dakesan/cat-robot-straight-learning/projects/cat-robot-learning/src/catrobot/assets/shapr3d-20261029/solid-01.obj

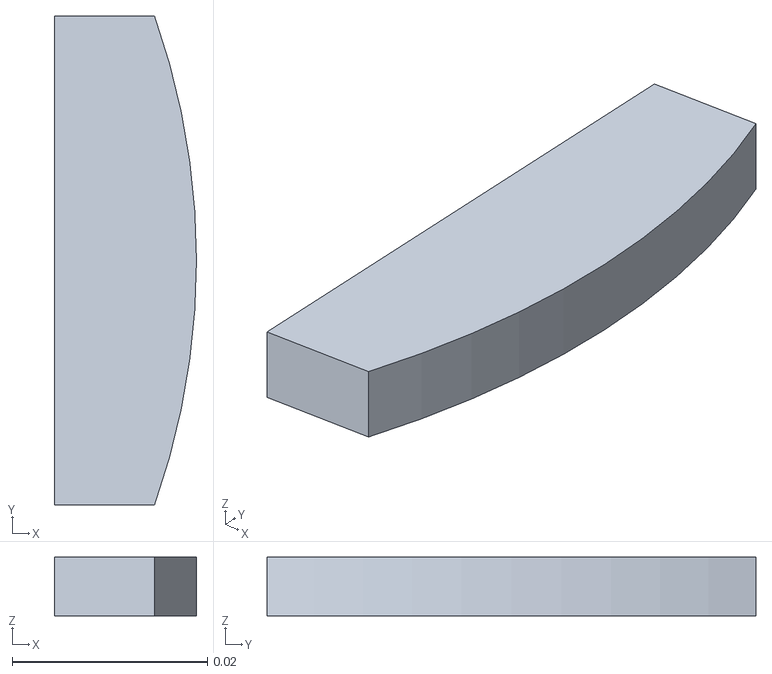
[picture p8: CAD file, 2026-11-01]
projects/cat-robot-learning/src/catrobot/assets/shapr3d-20261029/solid-01.obj
0.0145 x 0.05 x 0.006
