dakesan/cat-robot-straight-learning/projects/cat-robot-learning/src/catrobot/assets/shapr3d-20261029/solid-03.obj

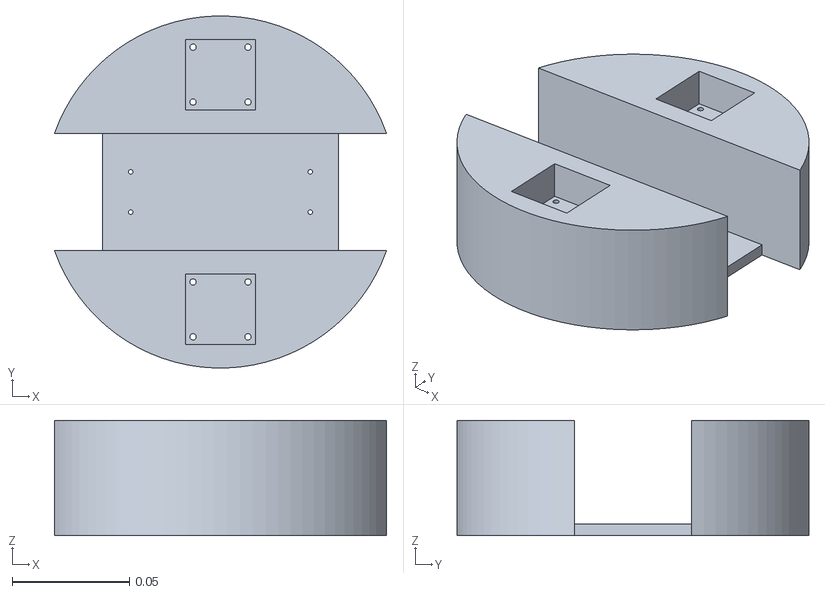
[picture p9: CAD file, 2026-11-01]
projects/cat-robot-learning/src/catrobot/assets/shapr3d-20261029/solid-03.obj
0.141 x 0.15 x 0.049
