dakesan/cat-robot-straight-learning/projects/cat-robot-learning/src/catrobot/assets/shapr3d-20261029/chassis.step

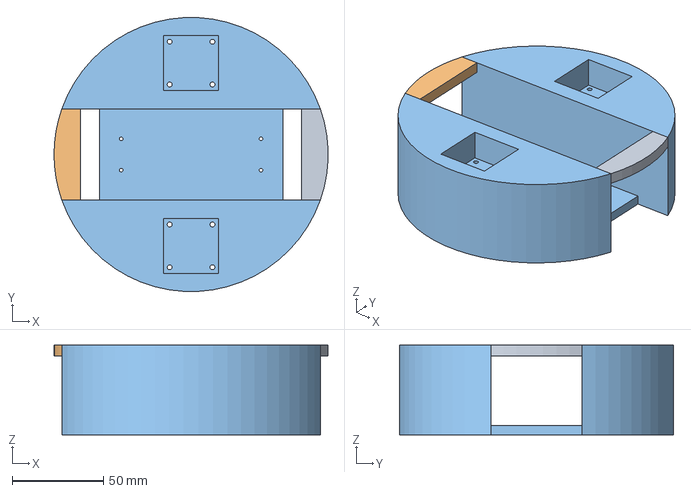
[picture p10: CAD file, 2026-11-01]
projects/cat-robot-learning/src/catrobot/assets/shapr3d-20261029/chassis.step
149.9 x 149.8 x 49.0 mm
