dakesan/cat-robot-straight-learning/(list of files, cad)

Other CAD files:
projects/cat-robot-learning/src/catrobot/assets/shapr3d-20261029/solid-02.obj
