dakesan/cat-robot-straight-learning/projects/cat-robot-learning/results/trials.csv

trial_id | mode | speed_mps | correction | reached | quality_ok | success | max_lateral_m | heading_at_goal_rad | actual_speed_mps | stop_reason
test-001 | learned | 0.19841580193530883 | -0.014000000432133675 | True | True | True | 0.028727962308805696 | -0.05019525522812085 | 0.21179367820335473 | distance_limit
test-002 | learned | 0.1116088885886112 | 0.0 | True | True | True | 0.02106388806200655 | -0.08650936205154153 | 0.11606004345787052 | distance_limit
test-003 | learned | 0.19841580193530883 | -0.014000000432133675 | True | True | True | 0.018354177280075507 | -0.08527584624385715 | 0.21153273803076222 | distance_limit
test-004 | learned | 0.19841580193530883 | -0.014000000432133675 | True | True | True | 0.02931461847031629 | -0.05832963854083323 | 0.2107251208407145 | distance_limit
test-005 | pwm | 0.1116088885886112 | 0 | True | True | False | 0.23711329595169575 | -0.560272423854538 | 0.07086808491968224 | distance_limit
test-006 | pwm | 0.1116088885886112 | 0 | True | True | False | 0.33128221308043126 | -0.9459681747684012 | 0.0761428198356508 | distance_limit
test-007 | speed | 0.1116088885886112 | 0 | True | False | False | 0.007746664431184245 | -0.021464813718599873 | 0.12092652291821913 | distance_limit
test-008 | learned | 0.1116088885886112 | 0.0 | True | False | False | 0.0351220154657616 | 0.06230654364571242 | 0.1193908371402048 | distance_limit
test-009 | speed | 0.19841580193530883 | 0 | True | True | False | 0.021781637239027582 | -0.09330388643760246 | 0.21713483266095174 | distance_limit
test-010 | speed | 0.19841580193530883 | 0 | True | True | False | 0.015389350291217964 | -0.09406529315491258 | 0.21755028923559336 | distance_limit
test-011 | speed | 0.19841580193530883 | 0 | True | True | True | 0.010348194937930268 | -0.08716766458091141 | 0.21572362431126602 | distance_limit
test-012 | pwm | 0.1116088885886112 | 0 | True | True | False | 0.22635095339982542 | -0.8612599917765418 | 0.07101982421872682 | distance_limit
test-013 | speed | 0.1116088885886112 | 0 | True | True | True | 0.044736967467648575 | 0.0786653722637678 | 0.1182418540645774 | distance_limit
test-014 | speed | 0.19841580193530883 | 0 | True | True | False | 0.040950600693013366 | -0.14537403704830337 | 0.21109495232551262 | distance_limit
test-015 | pwm | 0.19841580193530883 | 0 | True | True | False | 0.11513919119872677 | -0.4168624628521401 | 0.17470000375195627 | distance_limit
test-016 | pwm | 0.1116088885886112 | 0 | True | True | False | 0.2204490600744766 | -0.6912231483450344 | 0.0751453172359902 | distance_limit
test-017 | learned | 0.19841580193530883 | -0.014000000432133675 | True | True | True | 0.01029910097822298 | -0.00816658328205655 | 0.21651761337475822 | distance_limit
test-018 | pwm | 0.19841580193530883 | 0 | True | True | False | 0.1264019679162432 | -0.43714169287081994 | 0.17584957057899664 | distance_limit
test-019 | pwm | 0.1116088885886112 | 0 | True | True | False | 0.2785550519360426 | -0.8552427460024243 | 0.07361153160126307 | distance_limit
