dakesan/cat-robot-straight-learning/projects/cat-robot-wiring-visual/sketches/cat_robot/student_model.h

#pragma once
#include "drive.h"
// Student (label_correction) from measured runs; inputs are encoder-only.
inline robot::StudentModel deployedStudent() {
  robot::StudentModel m;
  m.fitted = true; m.measured = true;
  m.minSpeed = 1.116090000e-01f; m.maxSpeed = 1.984160000e-01f;
  m.minCorrection = -6.089146082e-02f; m.maxCorrection = 3.129026078e-02f;
  m.trackM = 1.400000000e-01f; m.elapsedCap = 3.000000000e+00f;
  const float mean[] = {1.414041419e-01f, 2.353905391e+00f, 1.397057154e-01f, 1.414289017e-01f, 4.971116803e-02f}, scale[] = {4.121500215e-02f, 8.993082758e-01f, 4.748435121e-02f, 4.852208662e-02f, 1.011489971e-01f};
  for (int i = 0; i < robot::StudentModel::INPUTS; ++i) { m.mean[i] = mean[i]; m.scale[i] = scale[i]; }
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
  constexpr int I = robot::StudentModel::INPUTS, H = robot::StudentModel::HIDDEN;
  for (int j = 0; j < H; ++j) {
    for (int i = 0; i < I; ++i) m.w1[j][i] = w1[j * I + i];
    for (int i = 0; i < H; ++i) m.w2[j][i] = w2[j * H + i];
    m.b1[j] = b1[j]; m.b2[j] = b2[j]; m.w3[j] = w3[j];
  }
  m.b3 = 1.271016099e-03f;
  return m;
}
inline const char* deployedStudentId() { return "5ff0b594a97265bc"; }
